Dillflix/moe-chassis/cad/chassis/6U_Chassis_Step_16.step

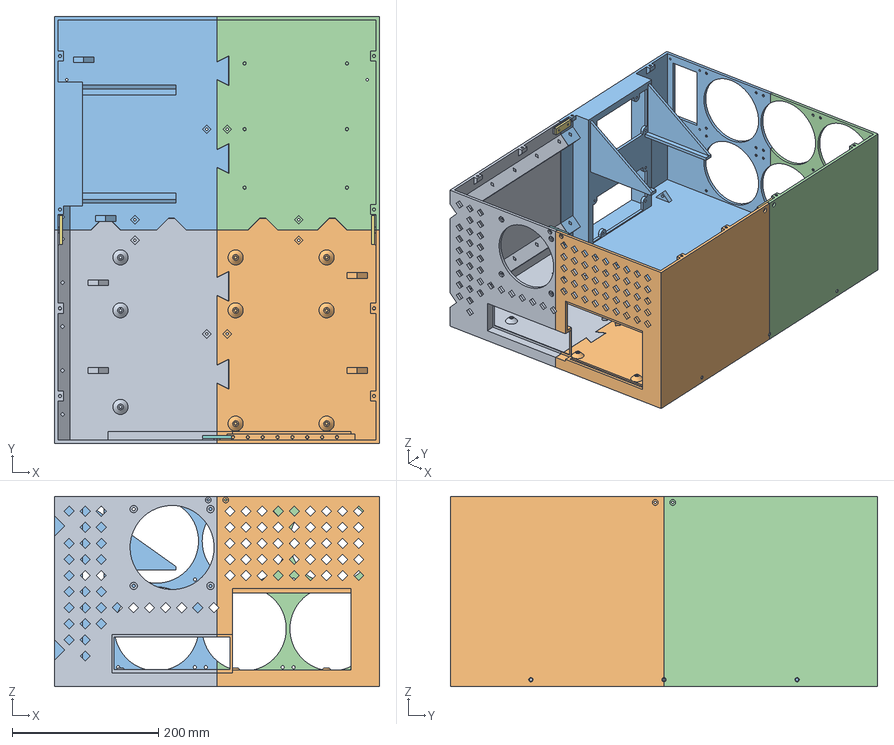
[picture p4: CAD file, 2026-10-25]
cad/chassis/6U_Chassis_Step_16.step
444.5 x 584.2 x 260.4 mm
REAR_RIGHT
REAR_LEFT
FRONT_RIGHT
FRONT_LEFT
Splice_1
Splice_2
Splice_3
Splice_4
Splice_5
Splice_6
Splice_7
