Dillflix/moe-chassis/cad/ducts/Duct20_PAIR_B_REAR_RISER_10.step

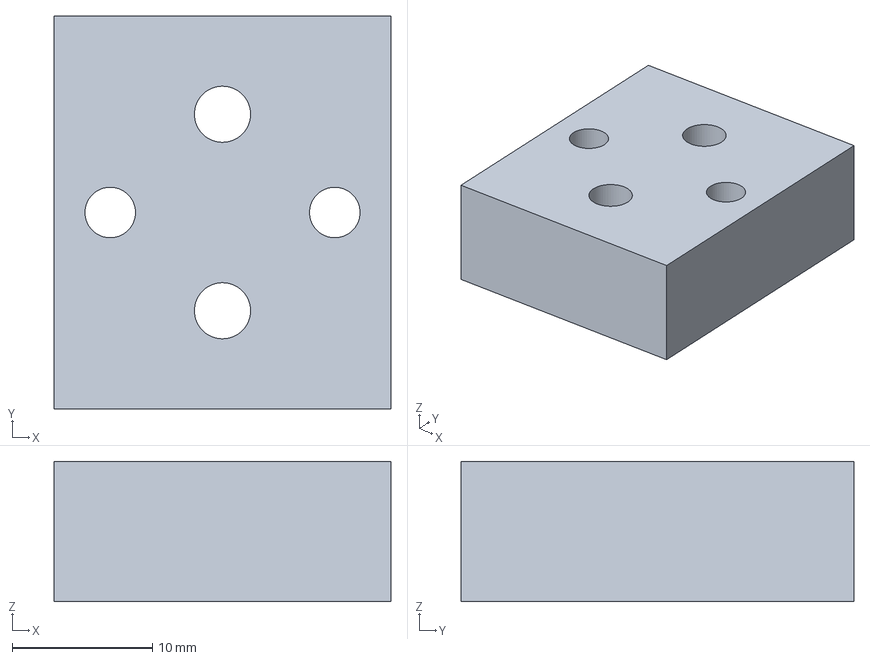
[picture p5: CAD file, 2026-10-25]
cad/ducts/Duct20_PAIR_B_REAR_RISER_10.step
24.0 x 28.0 x 10.0 mm
