Dillflix/moe-chassis/cad/lid/MOE_Lid_Step21.step

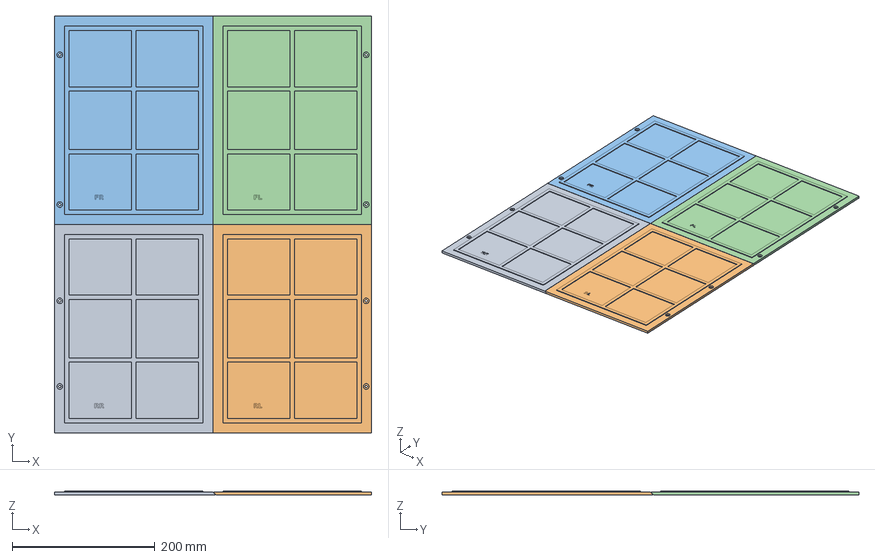
[picture p6: CAD file, 2026-10-25]
cad/lid/MOE_Lid_Step21.step
444.5 x 584.2 x 5.00 mm
REAR_RIGHT
REAR_LEFT
FRONT_RIGHT
FRONT_LEFT
