Dillflix/moe-chassis/cad/references/V620_Two_GPU_Interface.step

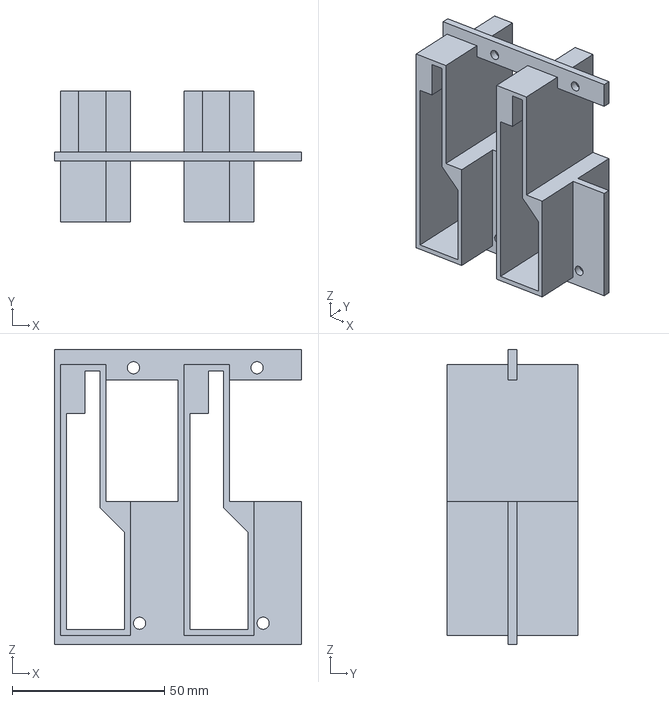
[picture p7: CAD file, 2026-10-25]
cad/references/V620_Two_GPU_Interface.step
81.3 x 43.0 x 97.0 mm
