Dillflix/moe-chassis/cad/ducts/Duct20_PAIR_A_FRONT_SLIDER.step

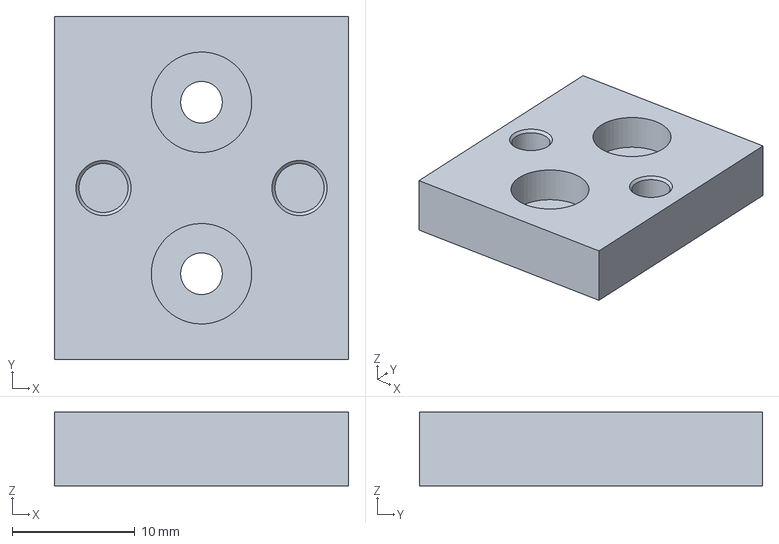
[picture p8: CAD file, 2026-10-25]
cad/ducts/Duct20_PAIR_A_FRONT_SLIDER.step
24.0 x 28.0 x 6.00 mm
