Dillflix/moe-chassis/cad/references/V620_Interface_Trim_Removed_Reference.step

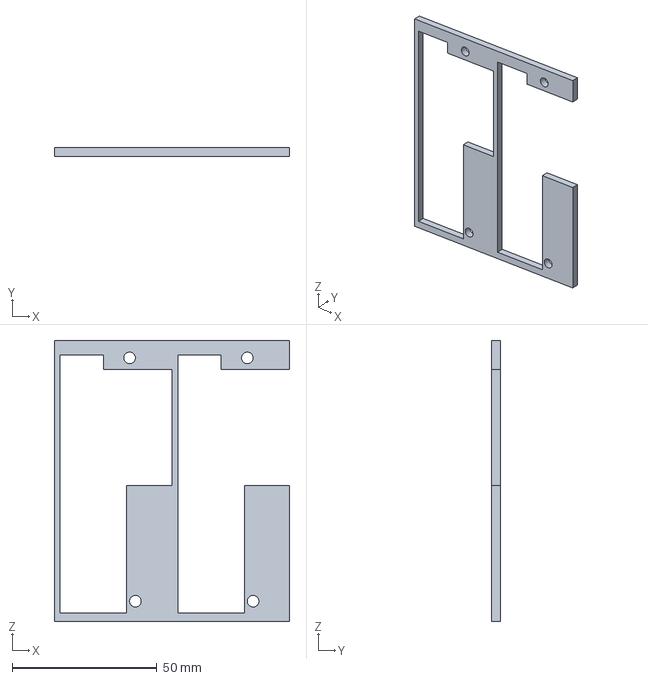
[picture p9: CAD file, 2026-10-25]
cad/references/V620_Interface_Trim_Removed_Reference.step
81.3 x 3.00 x 97.0 mm
