Dillflix/moe-chassis/cad/references/V620_Trimmed_Interface_Step19.step

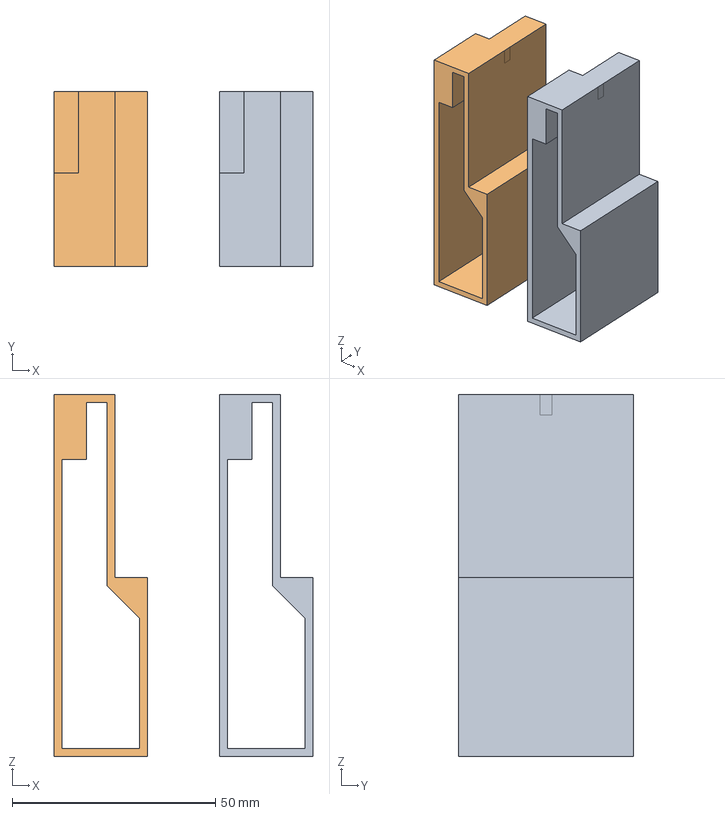
[picture p10: CAD file, 2026-10-25]
cad/references/V620_Trimmed_Interface_Step19.step
63.6 x 43.0 x 89.0 mm
