Dillflix/moe-chassis/cad/references/Duct18_Fan_Envelopes_Reference.step

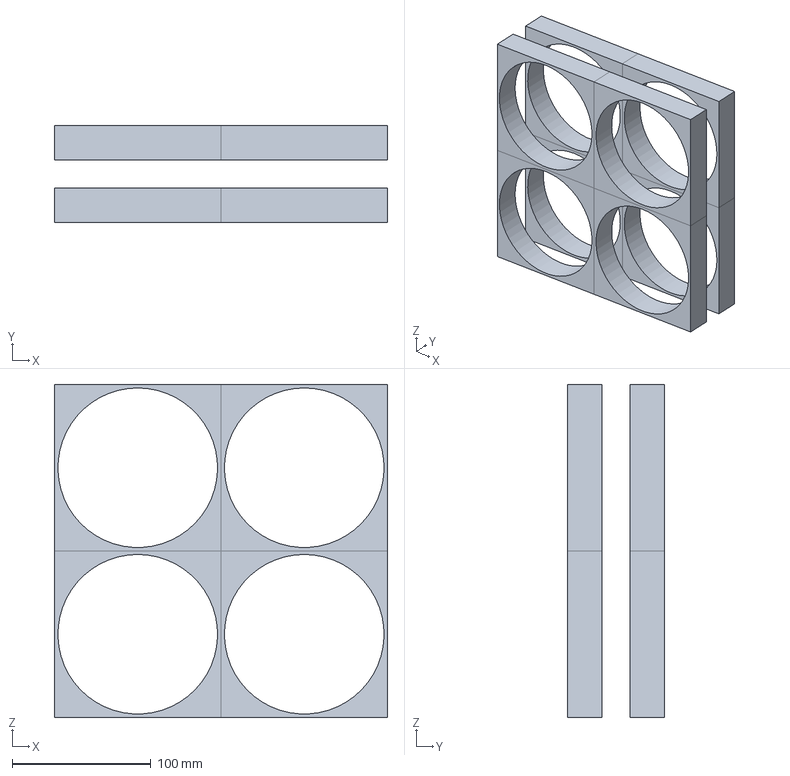
[picture p11: CAD file, 2026-10-25]
cad/references/Duct18_Fan_Envelopes_Reference.step
240.0 x 70.0 x 240.0 mm
