Dillflix/moe-chassis/cad/ducts/Duct20_FAN_BANK_CARRIER.step

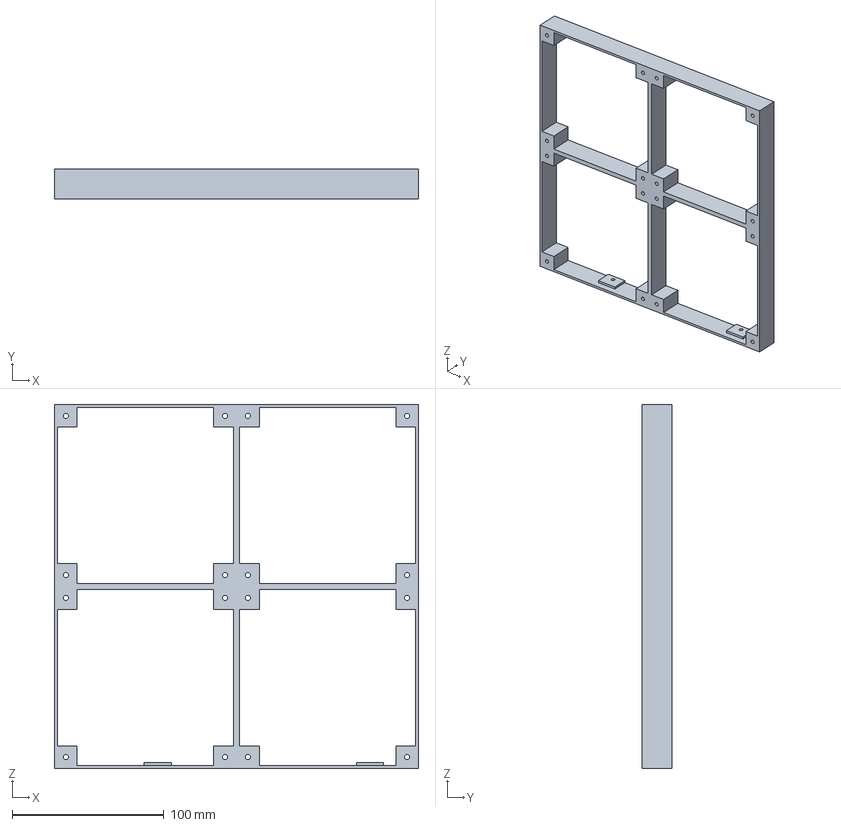
[picture p12: CAD file, 2026-10-25]
cad/ducts/Duct20_FAN_BANK_CARRIER.step
240.0 x 20.0 x 240.0 mm
