Dillflix/moe-chassis/cad/ducts/MOE_Duct_Retaining_Bar_Step22.step

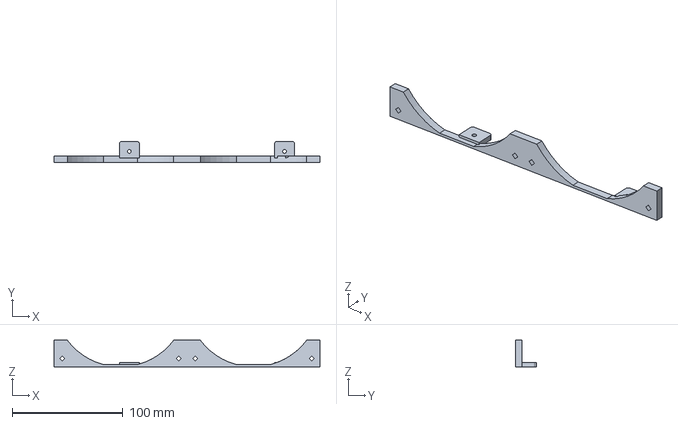
[picture p13: CAD file, 2026-10-25]
cad/ducts/MOE_Duct_Retaining_Bar_Step22.step
240.0 x 19.0 x 24.0 mm
