Dillflix/moe-chassis/cad/ducts/Duct20_PAIR_B_DUCT.step

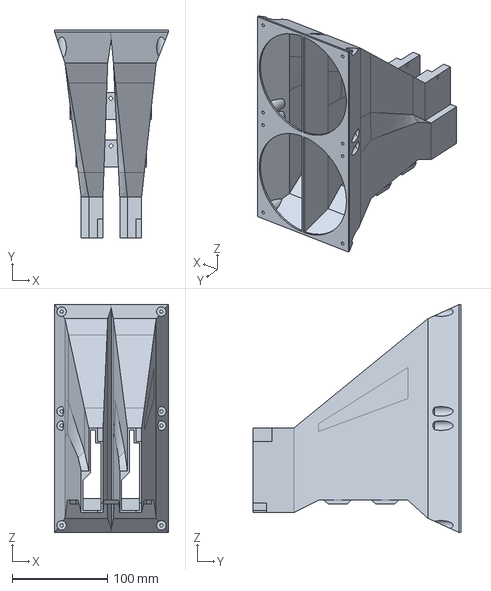
[picture p14: CAD file, 2026-10-25]
cad/ducts/Duct20_PAIR_B_DUCT.step
120.0 x 219.0 x 240.0 mm
