Dillflix/moe-chassis/cad/ducts/Duct20_PAIR_B_REAR_SADDLE.step

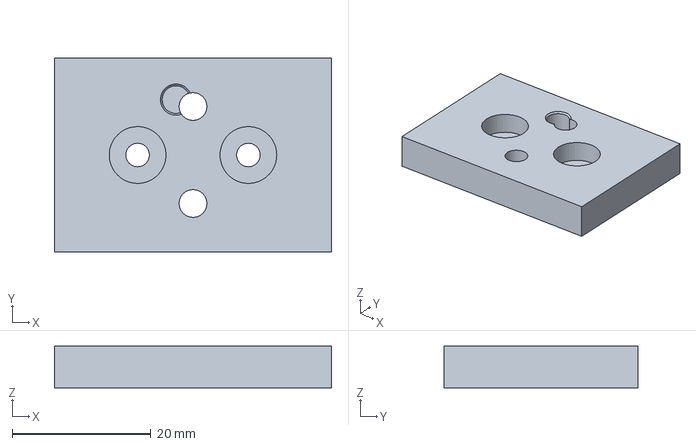
[picture p15: CAD file, 2026-10-25]
cad/ducts/Duct20_PAIR_B_REAR_SADDLE.step
40.0 x 28.0 x 6.00 mm
