Dillflix/moe-chassis/cad/ducts/Duct20_PAIR_B_BASE.step

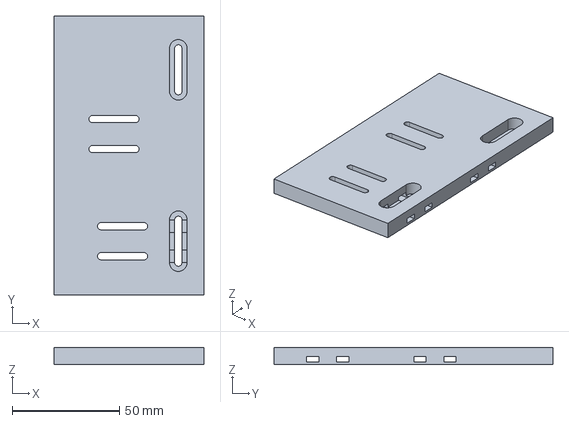
[picture p16: CAD file, 2026-10-25]
cad/ducts/Duct20_PAIR_B_BASE.step
70.0 x 130.0 x 8.00 mm
