Dillflix/moe-chassis/cad/ducts/Duct20_PAIR_A_DUCT.step

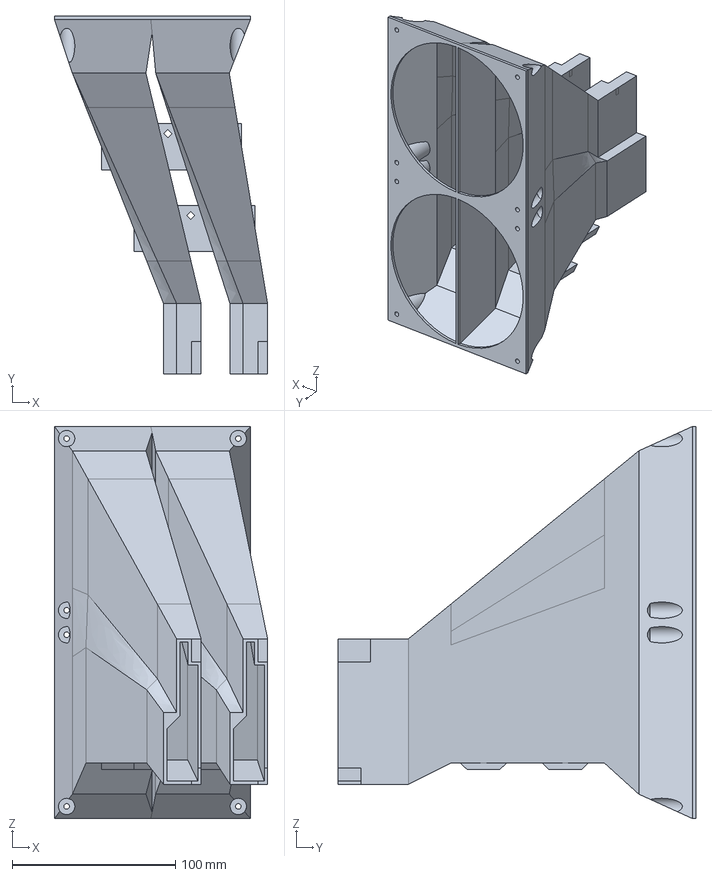
[picture p17: CAD file, 2026-10-25]
cad/ducts/Duct20_PAIR_A_DUCT.step
130.4 x 219.0 x 240.0 mm
