Dillflix/moe-chassis/cad/ducts/Duct20_PAIR_A_BASE.step

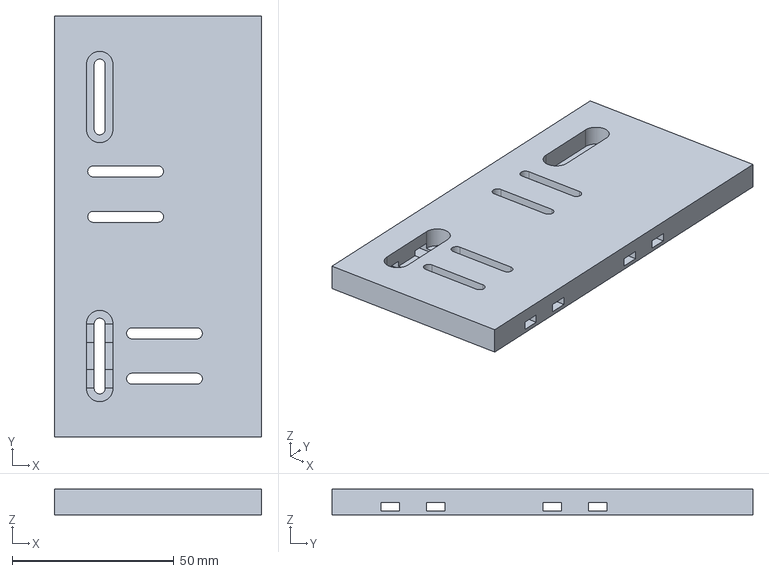
[picture p18: CAD file, 2026-10-25]
cad/ducts/Duct20_PAIR_A_BASE.step
64.0 x 130.0 x 8.00 mm
