Dillflix/moe-chassis/(list of files, cad)

Other CAD files:
cad/ducts/Duct20_PAIR_A_REAR_SLIDER.step
cad/ducts/Duct20_PAIR_A_REAR_RISER_10.step
cad/ducts/Duct20_PAIR_A_FRONT_RISER_10.step
cad/ducts/Duct20_PAIR_A_REAR_SADDLE.step
cad/ducts/Duct20_PAIR_A_FRONT_SADDLE.step
cad/ducts/Duct20_PAIR_B_FRONT_SADDLE.step
cad/ducts/Duct20_PAIR_B_FRONT_RISER_10.step
cad/ducts/Duct20_PAIR_B_REAR_SLIDER.step
cad/ducts/Duct20_PAIR_B_FRONT_SLIDER.step
